netube99/BAILING_V1/Datasheet/cm108ah电路参考.png

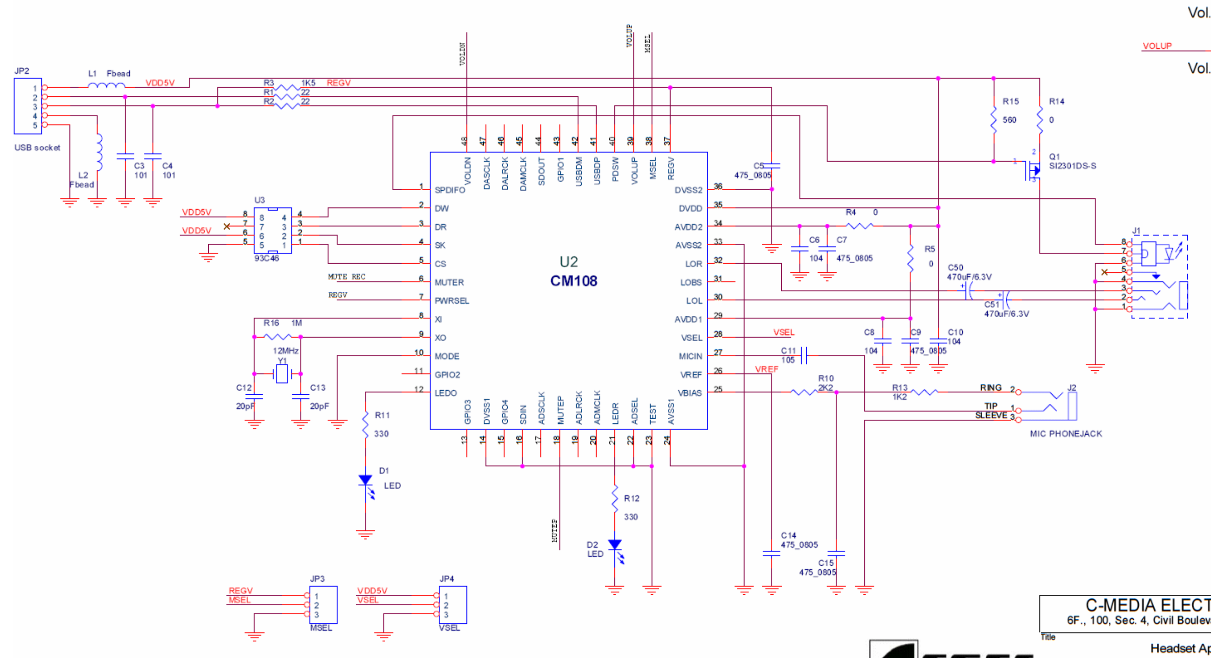
Datasheet/cm108ah电路参考.png
