netube99/BAILING_V1/Datasheet/铝壳/3232铝壳尺寸.png

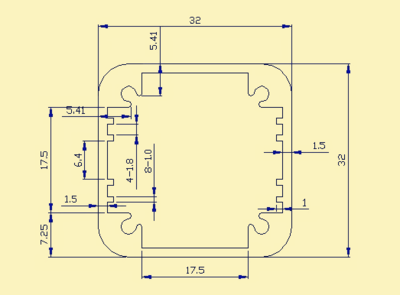
Datasheet/铝壳/3232铝壳尺寸.png
