netube99/BAILING_V1/Datasheet/铝壳/凯/装配体.SLDASM

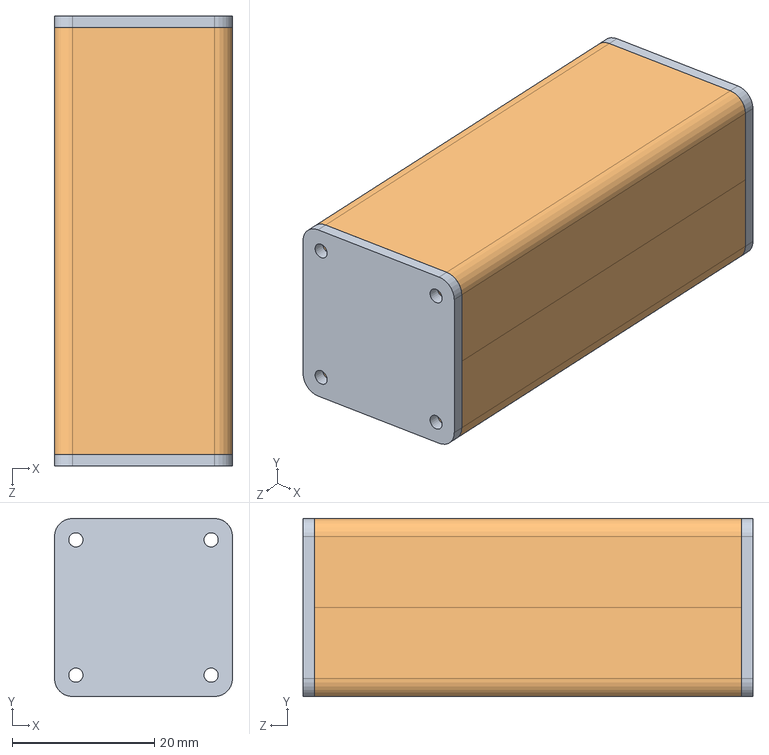
[picture p5: CAD file, 2021-03-17]
Datasheet/铝壳/凯/装配体.SLDASM
25.0 x 25.0 x 63.2 mm
盖 x 2
铝盒 x 2
