netube99/BAILING_V1/Datasheet/铝壳/凯/铝盒.SLDPRT

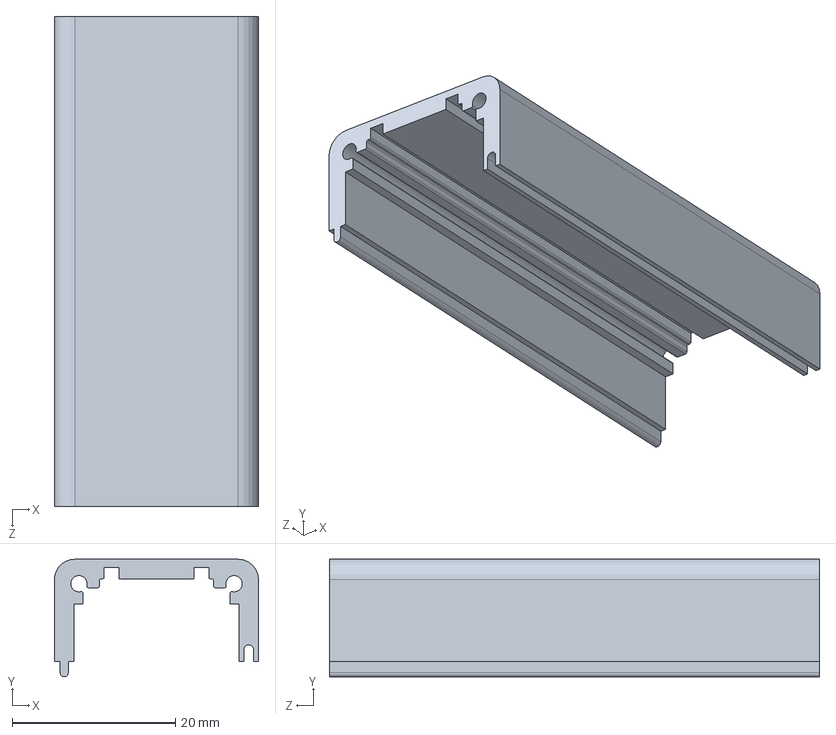
[picture p6: CAD file, 2021-03-17]
Datasheet/铝壳/凯/铝盒.SLDPRT
25.0 x 14.4 x 60.0 mm
