netube99/BAILING_V1/Datasheet/铝壳/凯/盖.SLDPRT

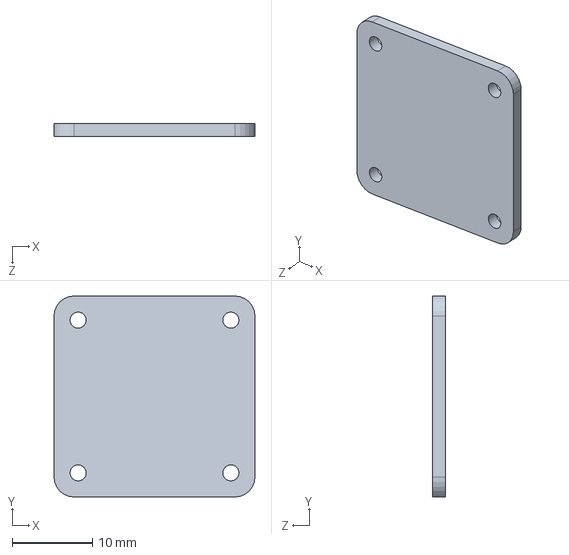
[picture p7: CAD file, 2021-03-17]
Datasheet/铝壳/凯/盖.SLDPRT
25.0 x 25.0 x 1.60 mm
