netube99/BAILING_V1/(list of files, cad)

Other CAD files:
Datasheet/铝壳/3232.dwg
Datasheet/铝壳/凯/零件1.SLDPRT
