netube99/BAILING_V1/PCB/MainBoard/MainBoard.pdf

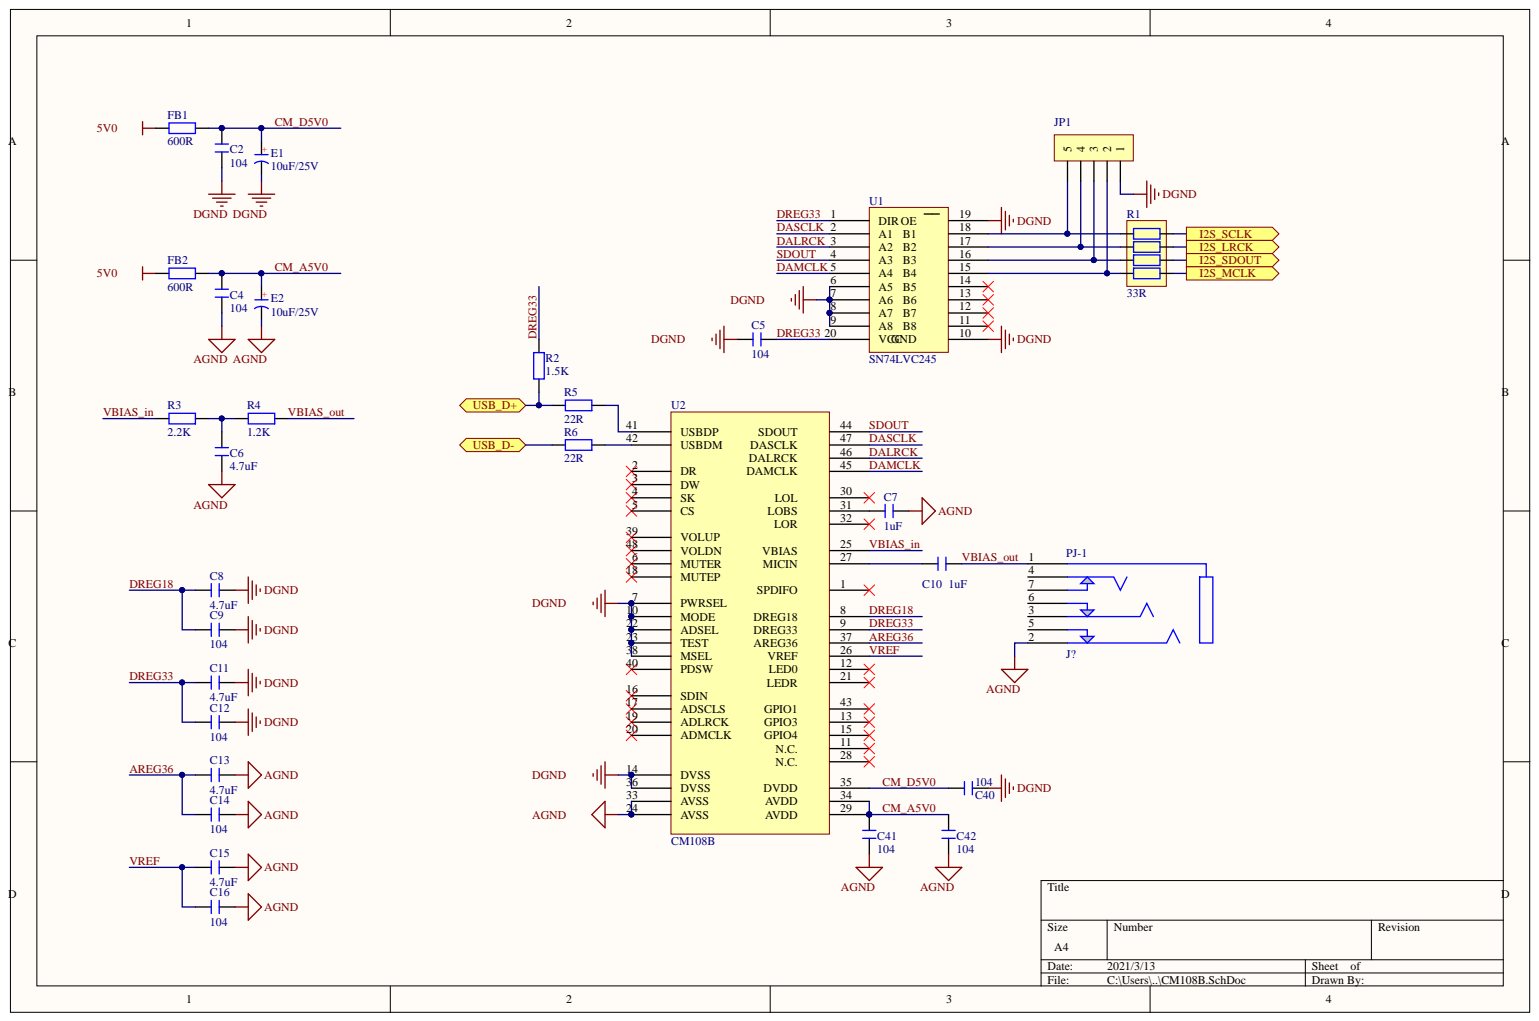
[picture p8: page 1]

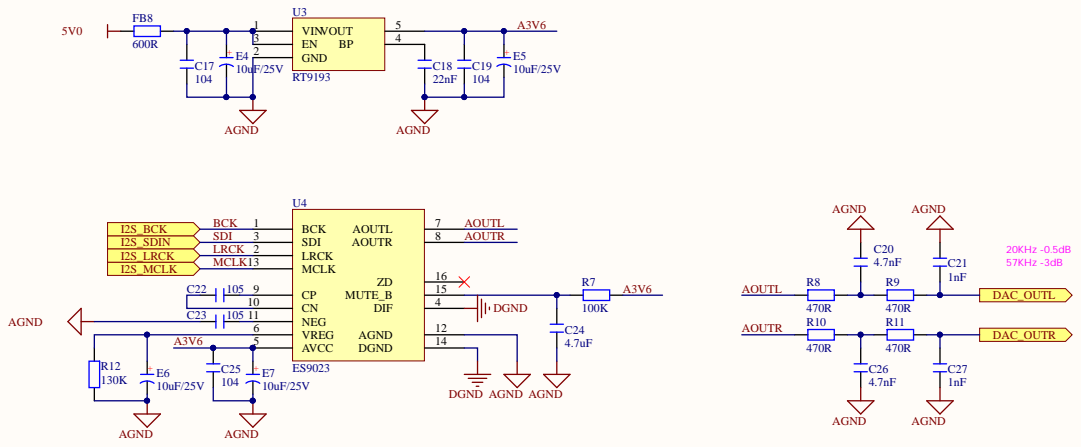
[picture p9: page 2]

NEG 11

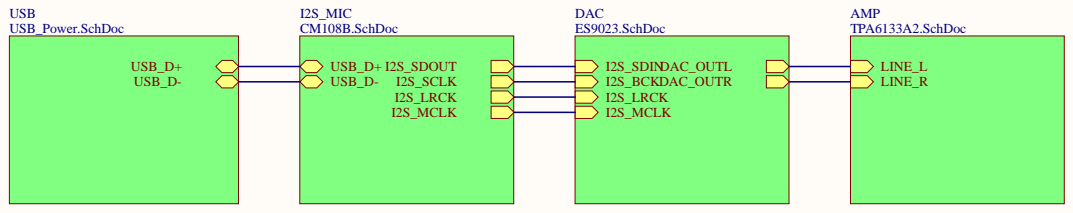
[picture p10: page 3]

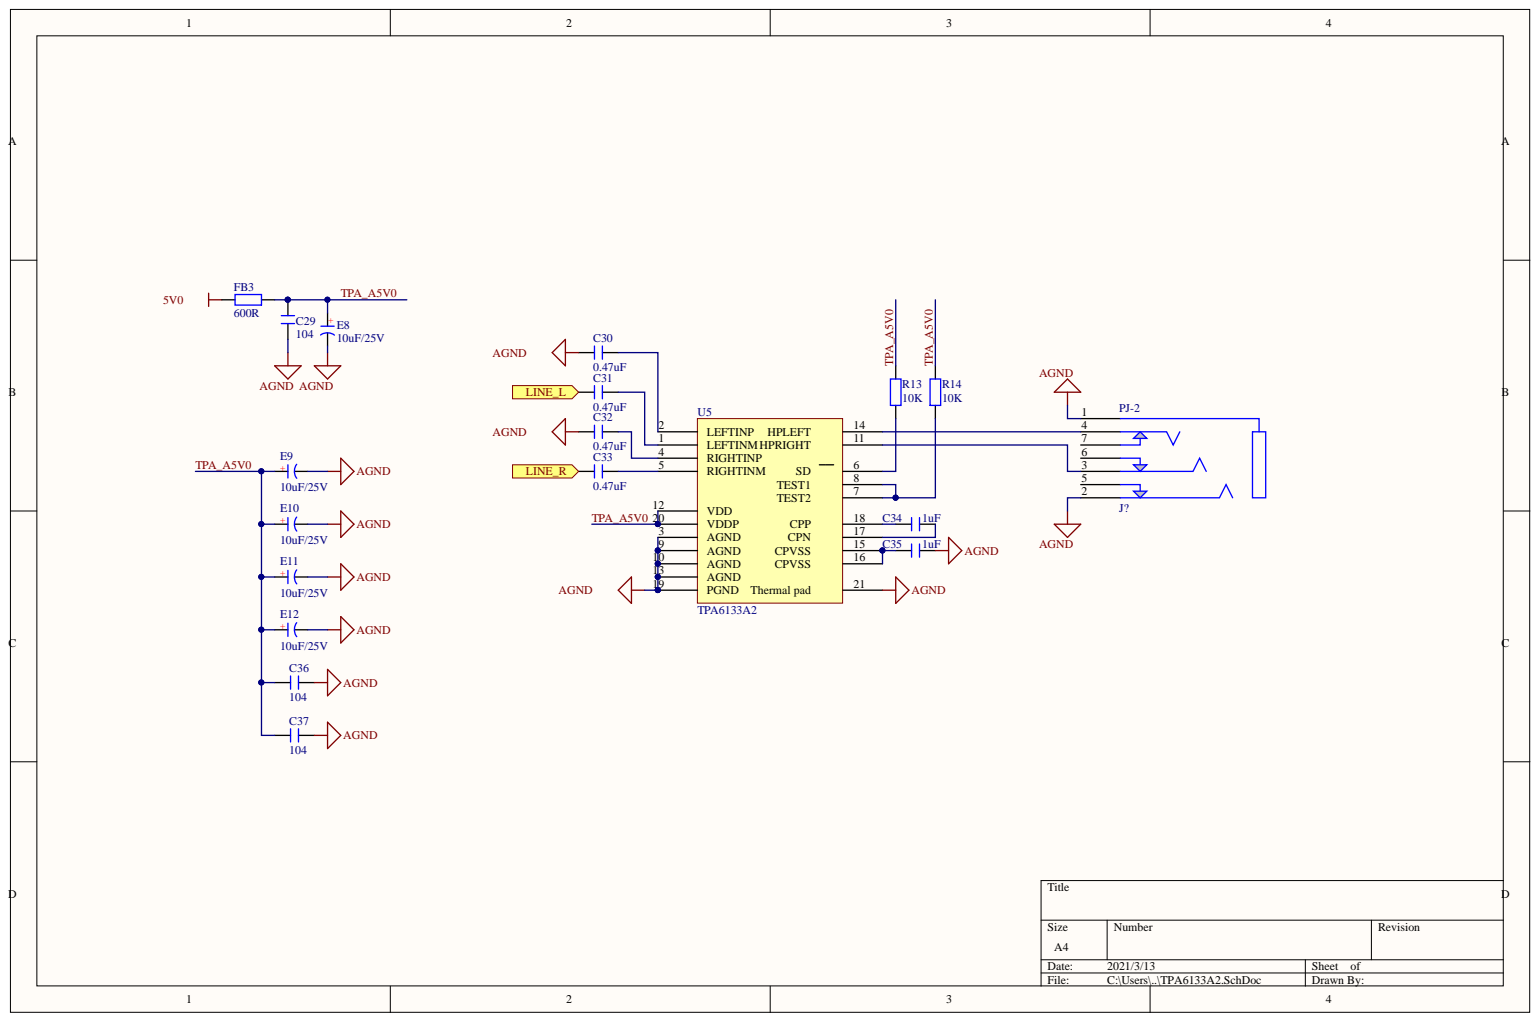
[picture p11: page 4]

RIGHTINP 4 | 6

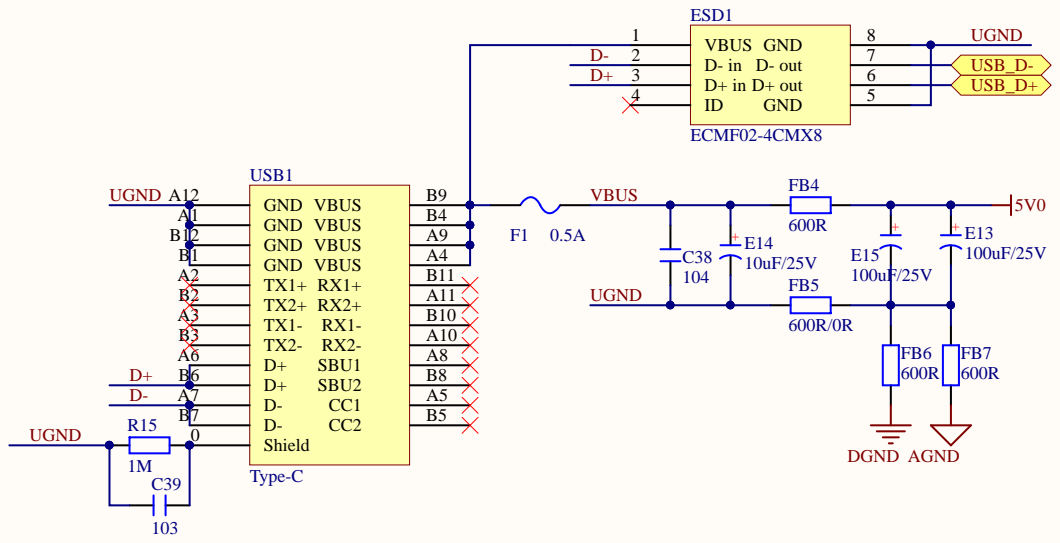
[picture p12: page 5]

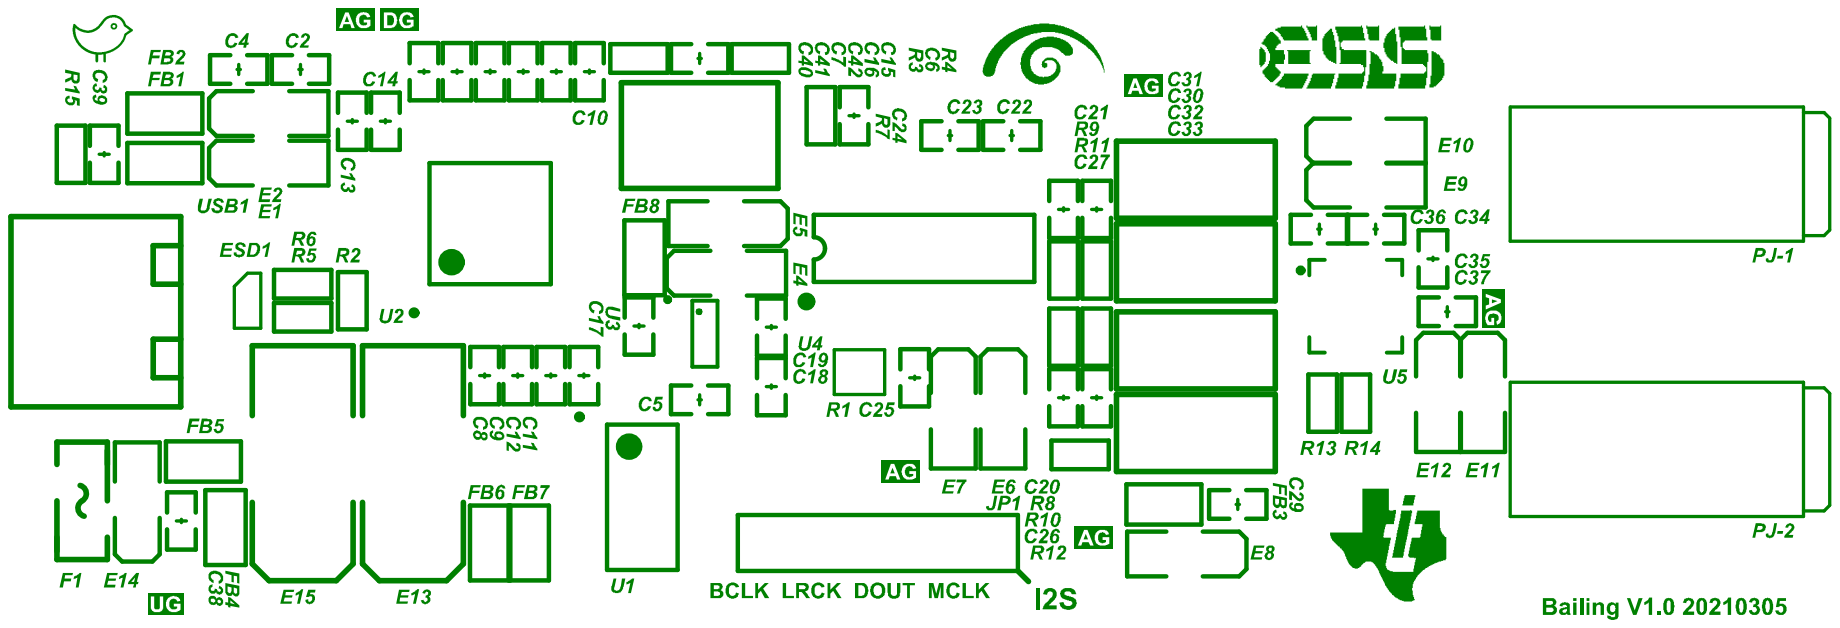
[picture p13: page 6]
