netube99/BAILING_V1/(list of files, drawings)

Other design files:
PCB/MainBoard/CM108B.SchDoc
PCB/MainBoard/ES9023.SchDoc
PCB/MainBoard/MainBoard.PrjPCB
PCB/MainBoard/Root.SchDoc
PCB/MainBoard/TPA6133A2.SchDoc
PCB/MainBoard/USB_Power.SchDoc
PCB/Panel1/Panel1.PrjPCB
PCB/Panel1/Panel1.SchDoc
PCB/Panel2/Panel2.PrjPCB
PCB/Panel2/Panel2.SchDoc
PCB/仿真测试/RC低通滤波.ms14
