netube99/BAILING_V1/(commit log)

2021-03-17 初次提交
    [3232.dwg, CM108B.SchDoc, ES9023.SchDoc, MainBoard.PrjPCB, Panel1.PrjPCB, Panel1.SchDoc, Panel2.PrjPCB, Panel2.SchDoc]
2021-12-06 修改分辨率
